aspyra/Arduboy_AS_flavor/kicad_PCB_files/pcb_v0.2.png

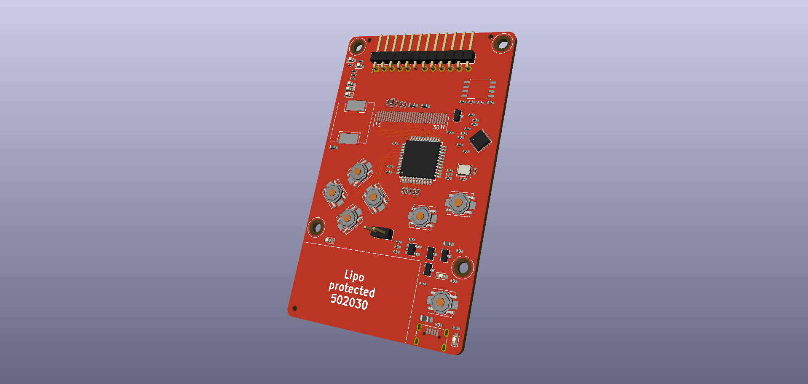
kicad_PCB_files/pcb_v0.2.png
