aspyra/Arduboy_AS_flavor/Misc/ssh1106_30pin_1.3inch_dimensions.png

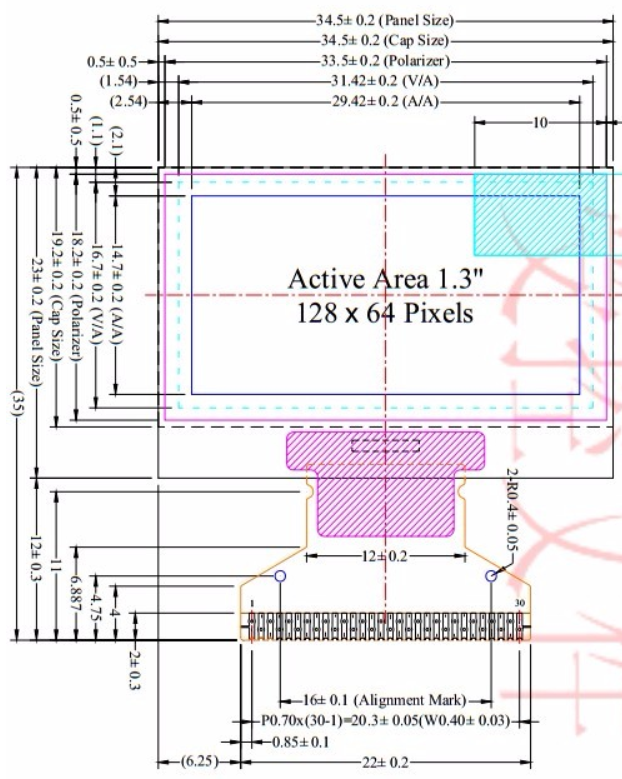
Misc/ssh1106_30pin_1.3inch_dimensions.png
