aspyra/Arduboy_AS_flavor/Misc/pinout_ssd1306.jpg

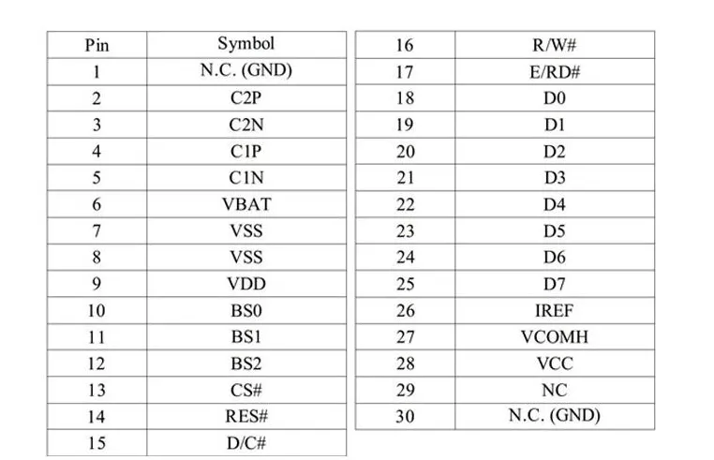
Misc/pinout_ssd1306.jpg
