aspyra/Arduboy_AS_flavor/Misc/pinout_ssh1106.jpg

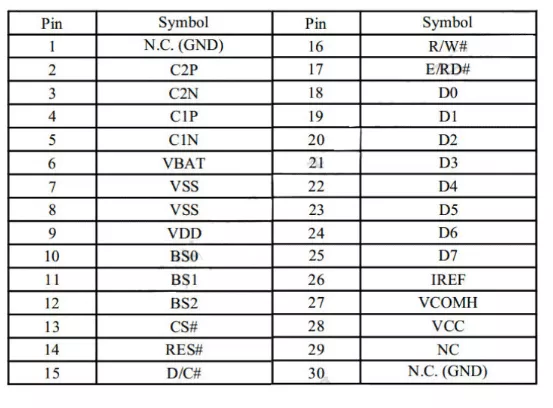
Misc/pinout_ssh1106.jpg
