aspyra/Arduboy_AS_flavor/Misc/ssd1306_recommended_capacitors.png

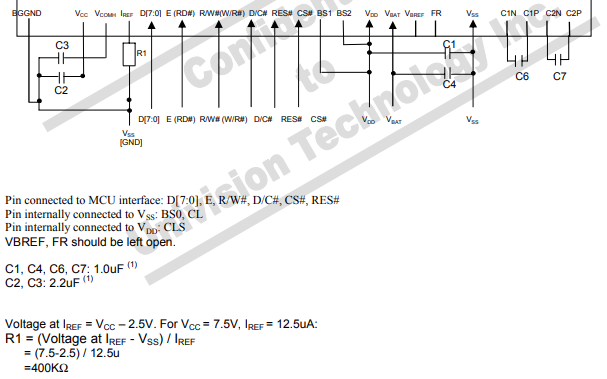
Misc/ssd1306_recommended_capacitors.png
