aspyra/Arduboy_AS_flavor/Misc/ssh1106_30pin_pinout.png

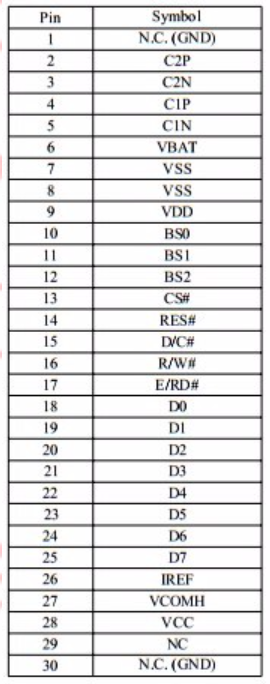
Misc/ssh1106_30pin_pinout.png
