aspyra/Arduboy_AS_flavor/Misc/ssh1106_recommended_capacitors.png

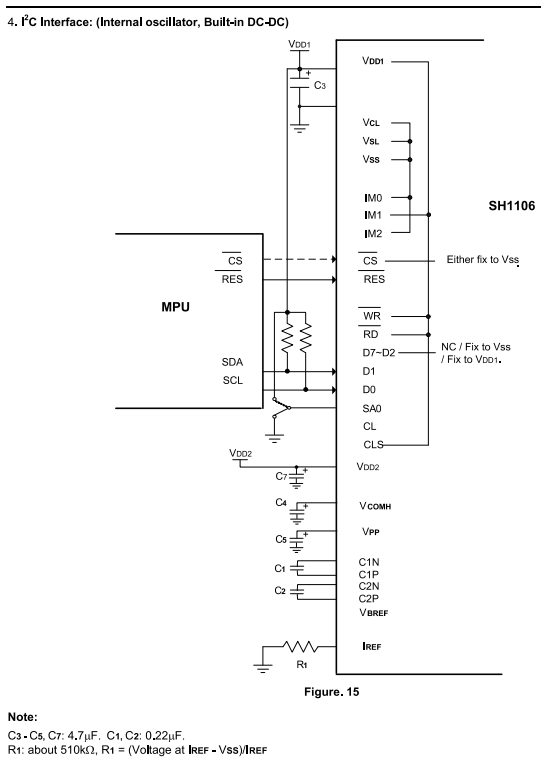
Misc/ssh1106_recommended_capacitors.png
