aspyra/Arduboy_AS_flavor/simulations/power switch v2.0/schematic.PNG

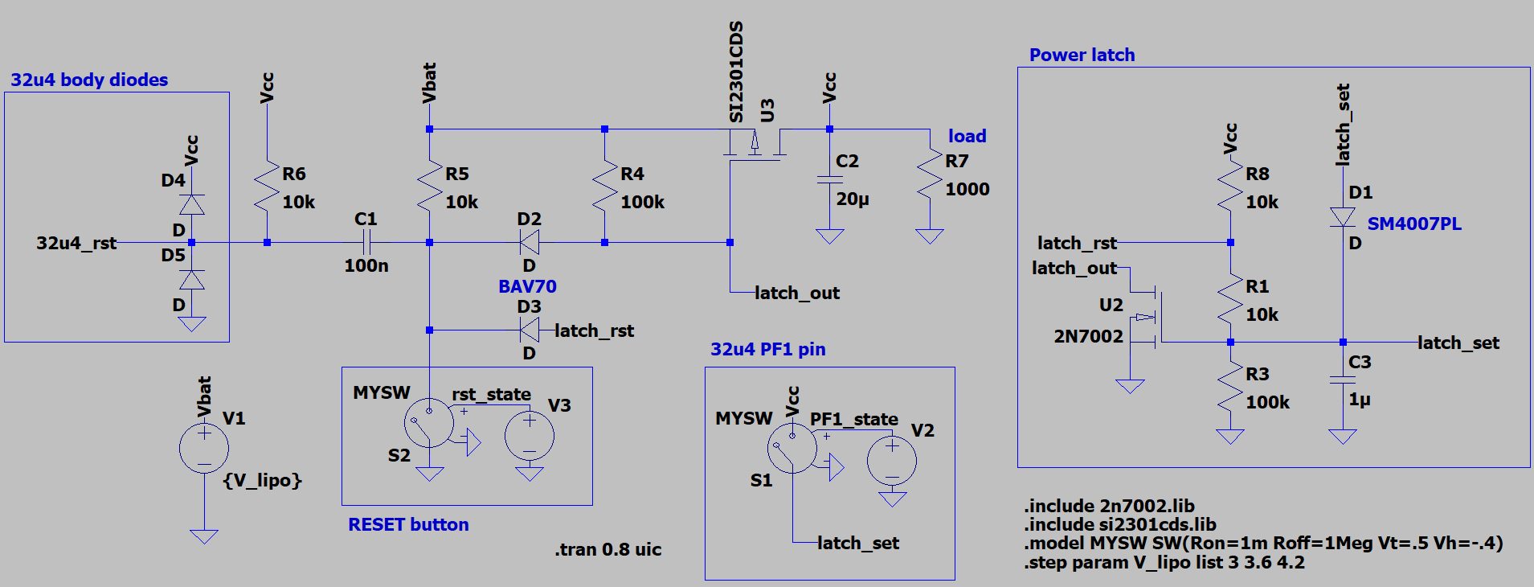
simulations/power switch v2.0/schematic.PNG
