aspyra/Arduboy_AS_flavor/kicad_PCB_files/schematic_v0.2.pdf

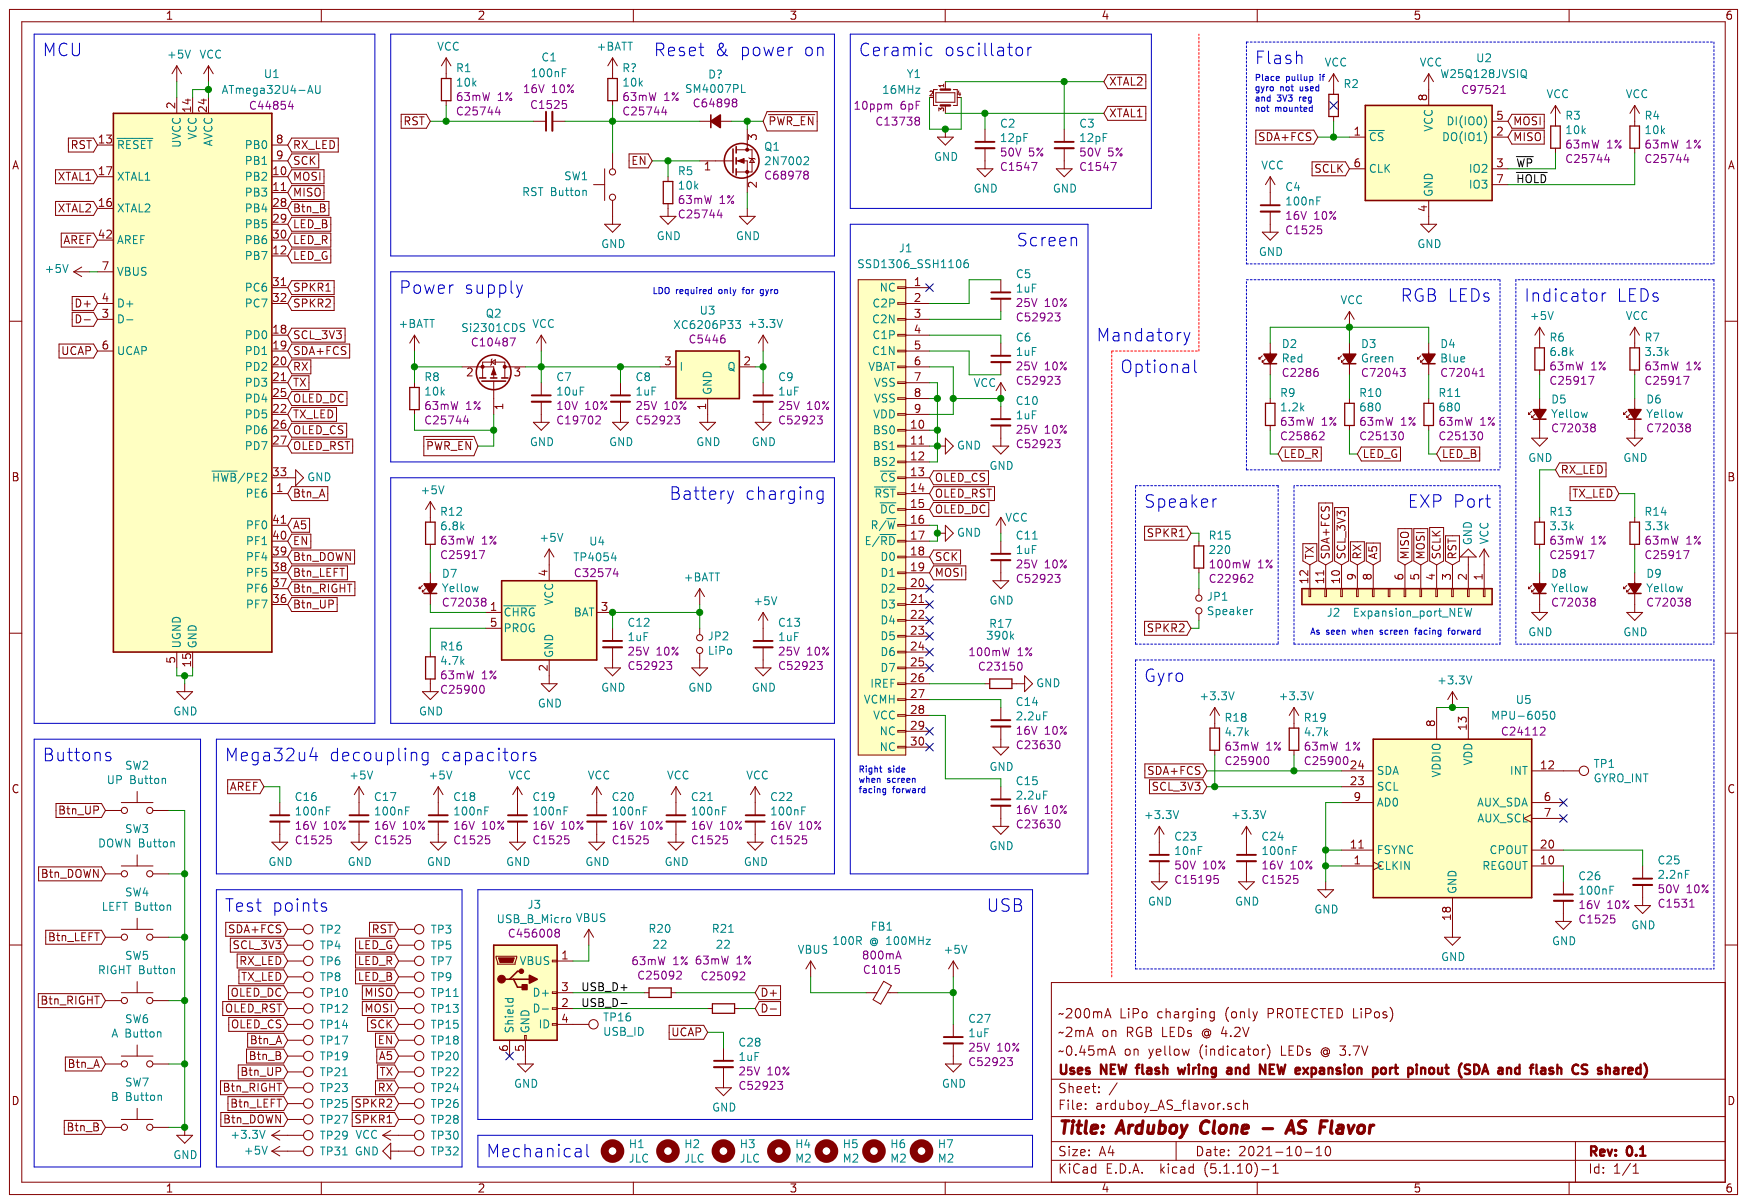
[picture p9: page 1]
