aspyra/Arduboy_AS_flavor/kicad_PCB_files/Old/schematic_v0.1.pdf

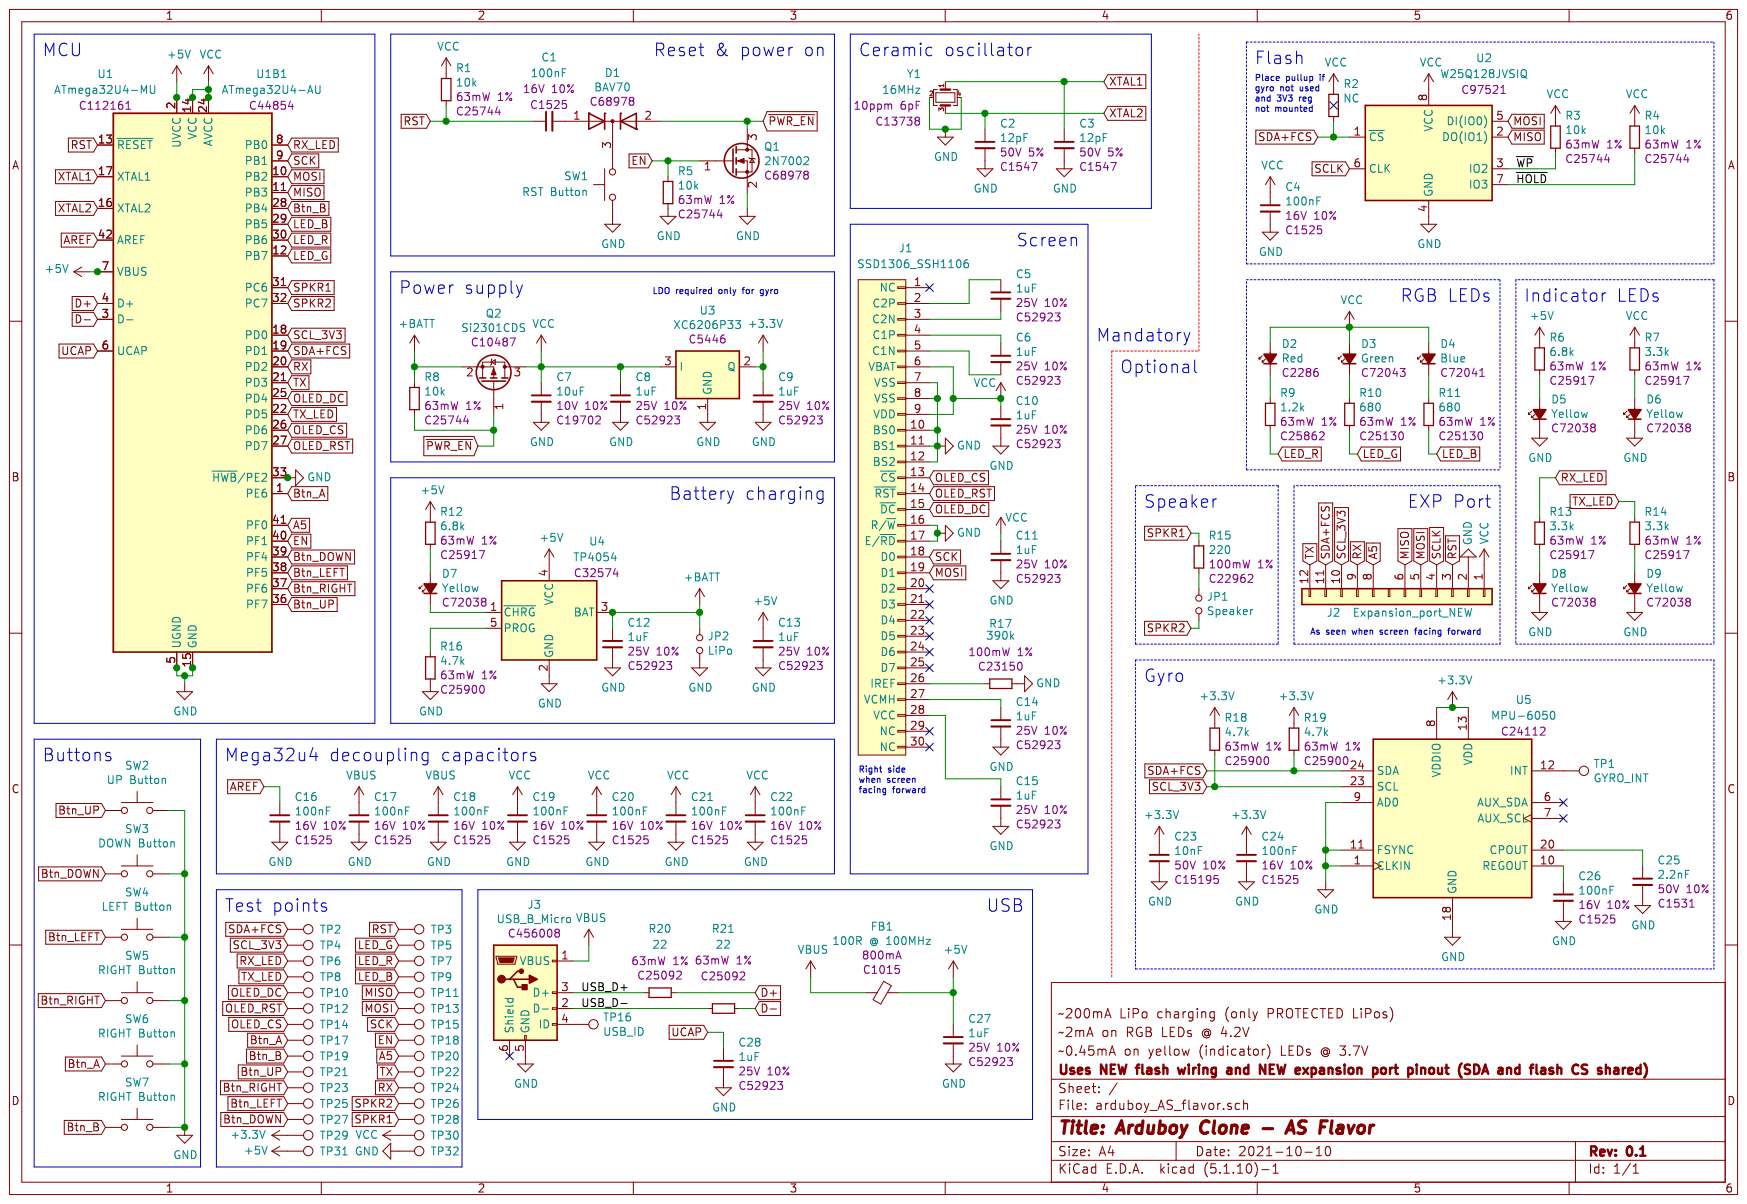
[picture p10: page 1]
