aspyra/Arduboy_AS_flavor/simulations/power switch v2.0/simulation.asc

C1: cap; 100n
C2: cap; 20µ; Rser=0
C3: cap; 1µ
D1: diode
D2: diode
D3: diode
D4: diode
D5: diode
R1: res; 680
R3: res; 100k
R4: res; 100k
R5: res; 10k
R6: res; 10k
R7: res; 100
S1: sw; MYSW
S2: sw; MYSW
U2: 2n7002
U3: si2301cds
V1: voltage; {V_lipo}
V2: voltage; PULSE(0 4.2 0.62 0.01m 0.01m 0.05 0.2 2)
V3: voltage; PULSE(0 4.2 0.4 0.01m 0.01m 0.03 0.2 4)
Named nets: 0, Vbat, Vcc, latch_set, 32u4_rst, latch_rst, rst_state, PF1_state, latch_out
.model MYSW SW(Ron=1m Roff=1Meg Vt=.5 Vh=-.4)
.tran 1.1 uic
.include si2301cds.lib
Power latch
.include 2n7002.lib
RESET button
32u4 PF1 pin
.step param V_lipo list 3 3.6 4.2
32u4 body diodes
load
BAV70
SM4007PL
