aspyra/Arduboy_AS_flavor/kicad_PCB_files/arduboy_AS_flavor.kicad_pcb

## KiCad design kicad_PCB_files/arduboy_AS_flavor.kicad_pcb (2023-05-02)

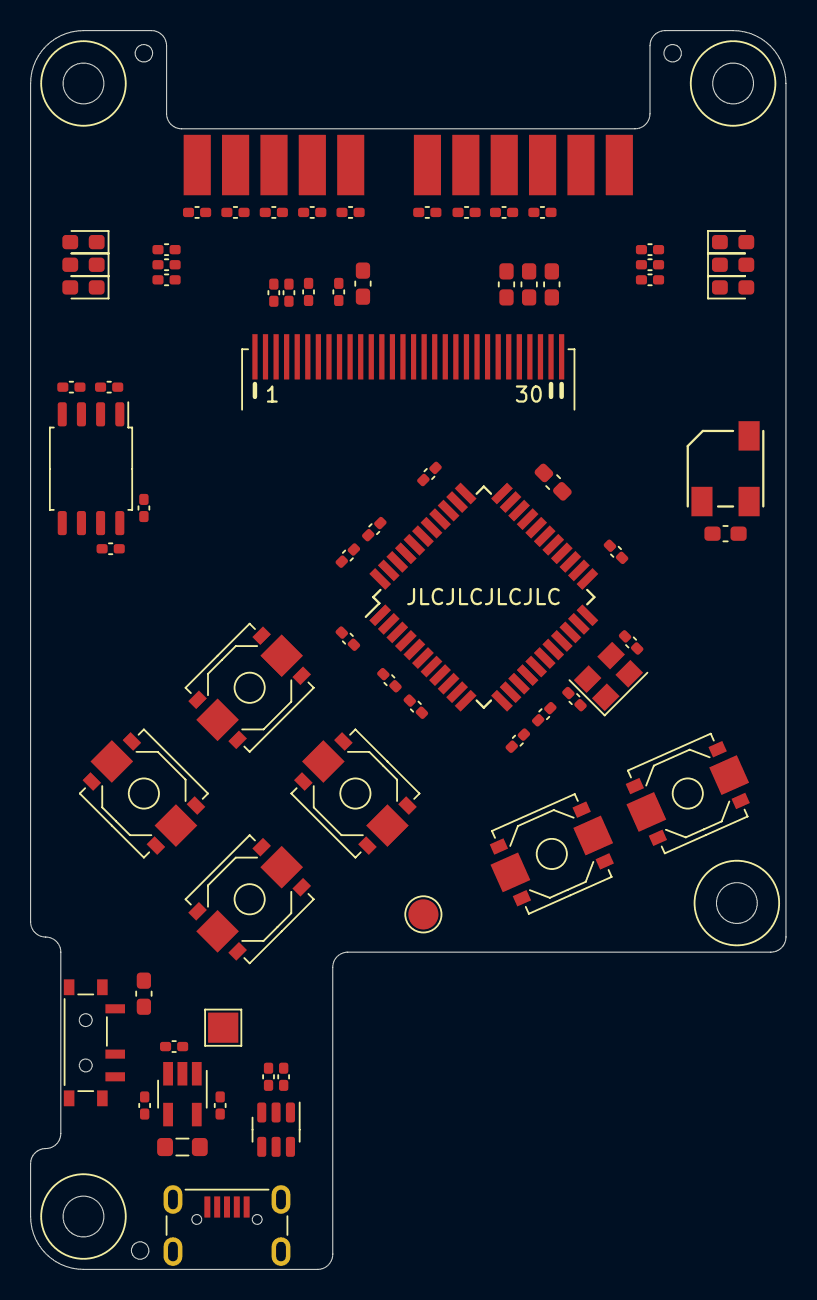
[picture p11: board arduboy_AS_flavor.kicad_pcb from above]

Board: 4 copper layers, 50.0 x 82.0 mm, 78 parts (0 on the bottom side), 66 nets, no tracks yet.

Parts:
BZ1: Buzzer; Buzzer_KLJ-5020
C1, C7, C8: 10uF; 0603_HandSolder
C2, C3: 12pF; 0402_HandSolder
C4, C16, C17, C18, C19, C20, C21, C22: 100nF; 0402_HandSolder
C5, C6, C10, C11, C12, C13, C28: 1uF; 0402_HandSolder
C9, C15: 4.7uF; 0603_HandSolder
C14: 2.2uF; 0603_HandSolder
D2: Red; LED_0603_1608Metric_Pad1.05x0.95mm_HandSolder
D3: Green; LED_0603_1608Metric_Pad1.05x0.95mm_HandSolder
D4: Blue; LED_0603_1608Metric_Pad1.05x0.95mm_HandSolder
D7, D8, D9: Yellow; LED_0603_1608Metric_Pad1.05x0.95mm_HandSolder
FB1: 100R @ 100MHz; L_0805_2012Metric_Pad1.05x1.20mm_HandSolder
H1, H2, H3: JLC; JLCPCB_assembly_hole
H4, H5, H6, H7: M2; M2_mounting_hole
J1: SSD1306; SSD1306_30pin_P0.7mm
J2: Expansion_port_NEW; ExpansionPort_SMD
J3: USB_B_Micro; USB_MICRO_B_C456008
R1, R2, R3, R4: 10k; 0402_HandSolder
R5, R6, R7, R8, R18, R19, R22, R23, R24: 120; 0402_HandSolder
R9, R12, R13: 1.2k; 0402_HandSolder
R10, R11: 680; 0402_HandSolder
R14, R16: 4.7k; 0402_HandSolder
R17: 390k; 0603_HandSolder
R20, R21: 22; 0402_HandSolder
SW1: ON/OFF; Switch_DPDT_MSK12CO2-BDM
SW2: UP Button; button_TS-1187A-B-A-B
SW3: DOWN Button; button_TS-1187A-B-A-B
SW4: LEFT Button; button_TS-1187A-B-A-B
SW5: RIGHT Button; button_TS-1187A-B-A-B
SW6: A Button; button_TS-1187A-B-A-B
SW7: B Button; button_TS-1187A-B-A-B
TP1: Lipo [+]; TestPoint_Pad_2.0x2.0mm
TP16: Lipo (-); TestPoint_Pad_D2.0mm
U1: ATmega32U4-AU; TQFP-44_10x10mm_P0.8mm
U2: W25Q128JVSIQ; SOIC-8_5.23x5.23mm_P1.27mm
U3: SRV05-4; SOT-23-6
U4: TP4054; SOT-23-5_HandSoldering
Y1: 16MHz; Crystal_SMD_3225-4Pin_3.2x2.5mm

Connections:
+5V: C13.1, C17.1, C18.1, D7.2 (A), FB1.1, U1.2 (UVCC), U1.7 (VBUS), U4.4 (VCC)
+BATT: C12.1, SW1.2 (B), TP1.1, U4.3 (BAT)
/PROG: R16.1, U4.5 (PROG)
/USB_D+: J3.3 (D+), R20.1, U3.1 (IO1), U3.6 (IO4)
/USB_D-: J3.2 (D-), R21.1, U3.3 (IO2), U3.4 (IO3)
/~HOLD: R4.2, U2.7 (IO3)
/~WP: R3.2, U2.3 (IO2)
A5: R18.1, U1.41 (PF0)
AREF: C16.1, U1.42 (AREF)
Btn_A: SW6.1, U1.1 (PE6)
Btn_B: SW7.1, U1.28 (PB4)
Btn_DOWN: SW3.1, U1.39 (PF4)
Btn_LEFT: SW4.1, U1.38 (PF5)
Btn_RIGHT: SW5.1, U1.37 (PF6)
Btn_UP: SW2.1, U1.36 (PF7)
D+: R20.2, U1.4 (D+)
D-: R21.2, U1.3 (D-)
GND: C1.2, C2.2, C3.2, C4.2, C7.2, C8.2, C10.2, C11.2, C12.2, C13.2, C14.2, C15.2, C16.2, C17.2, C18.2, C19.2, C20.2, C21.2, C22.2, C28.2, J1.7 (VSS), J1.8 (VSS), J1.10 (BS0), J1.11 (BS1), J1.12 (BS2), J1.16 (R/~W), J1.17 (E/~RD), J2.2, J3.5 (GND), R16.2, R17.2, SW2.2, SW3.2, SW4.2, SW5.2, SW6.2, SW7.2, TP16.1, U1.5 (UGND), U1.15 (GND), U1.23 (GND), U1.33 (~HWB/PE2), U1.35 (GND), U1.43 (GND), U2.4 (GND), U3.2 (VN), U4.2 (GND), Y1.2, Y1.4
LED_B: R11.2, U1.29 (PB5)
LED_G: R10.2, U1.12 (PB7)
LED_R: R9.2, U1.30 (PB6)
MISO: R19.1, U1.11 (PB3), U2.2 (DO(IO1))
MOSI: J1.19 (D1), R22.1, U1.10 (PB2), U2.5 (DI(IO0))
unnamed: BZ1.1 (-), C9.2
unnamed: C5.1, J1.2 (C2P)
unnamed: C5.2, J1.3 (C2N)
unnamed: C6.1, J1.4 (C1P)
unnamed: C6.2, J1.5 (C1N)
unnamed: C14.1, J1.27 (VCMH)
unnamed: C15.1, J1.28 (VCC)
unnamed: D2.1 (K), R9.1
unnamed: D3.1 (K), R10.1
unnamed: D4.1 (K), R11.1
unnamed: D7.1 (K), R14.1
unnamed: D8.1 (K), R12.1
unnamed: D9.1 (K), R13.1
unnamed: J1.26 (IREF), R17.1
unnamed: J2.3, R24.2
unnamed: J2.4, R23.2
unnamed: J2.5, R22.2
unnamed: J2.6, R19.2
unnamed: J2.8, R18.2
unnamed: J2.9, R8.2
unnamed: J2.10, R7.2
unnamed: J2.11, R6.2
unnamed: J2.12, R5.2
OLED_CS: J1.13 (~CS), U1.26 (PD6)
OLED_DC: J1.15 (~DC), U1.25 (PD4)
OLED_RST: J1.14 (~RST), U1.27 (PD7)
RST: R1.2, R24.1, U1.13 (~RESET)
RX: R8.1, U1.20 (PD2)
RX_LED: R12.2, U1.8 (PB0)
SCK: J1.18 (D0), U1.9 (PB1)
SCL: R7.1, U1.18 (PD0)
SCLK: R23.1, U2.6 (CLK)
SDA+FCS: R2.2, R6.1, U1.19 (PD1), U2.1 (~CS)
SPKR1: C9.1, U1.31 (PC6)
SPKR2: BZ1.2 (+), U1.32 (PC7)
TX: R5.1, U1.21 (PD3)
TX_LED: R13.2, U1.22 (PD5)
UCAP: C28.1, U1.6 (UCAP)
VBUS: FB1.2, J3.1 (VBUS), U3.5 (VP)
VCC: C1.1, C4.1, C7.1, C8.1, C10.1, C11.1, C19.1, C20.1, C21.1, C22.1, D2.2 (A), D3.2 (A), D4.2 (A), D8.2 (A), D9.2 (A), J1.6 (VBAT), J1.9 (VDD), J2.1, R1.1, R2.1, R3.1, R4.1, SW1.1 (A), U1.14 (VCC), U1.24 (AVCC), U1.34 (VCC), U1.44 (AVCC), U2.8 (VCC)
XTAL1: C2.1, U1.17 (XTAL1), Y1.3
XTAL2: C3.1, U1.16 (XTAL2), Y1.1
~CHRG: R14.2, U4.1 (~CHRG)
