aspyra/Arduboy_AS_flavor/(commit log)

2021-10-08 Initial commit - Imported KiCAD files
    [arduboy_AS_flavor.kicad_pcb, arduboy_AS_flavor.sch]
2021-10-09 Multiple schematic changes Added SSH1106 connector (30 pin 0.7mm pitch)
    [arduboy_AS_flavor.sch]
2021-10-10 Added SSD1306, SSH1106 pinouts & capacitor recommendations
2021-10-10 v0.1 schematic Added screen connectors Added testpoints Exported v0.1 schematic as .pdf
    [arduboy_AS_flavor.sch]
2021-10-11 Changed screen capacitor's size and value PCB mockup added
    [arduboy_AS_flavor.kicad_pcb, arduboy_AS_flavor.sch]
2021-10-11 PCB changes - Button footprints for clicky OR silent switches
    [arduboy_AS_flavor.kicad_pcb, arduboy_AS_flavor.sch]
2021-10-12 Added footprints: JLCPCB assembly hole and my logo
2021-10-12 Added mechanical mounting points Continued PCB placement feasibility
    [arduboy_AS_flavor.kicad_pcb, arduboy_AS_flavor.sch]
2021-10-20 Changed reset circuit Continued PCB placement feasibility Changed piezo footprint
    [arduboy_AS_flavor.kicad_pcb, arduboy_AS_flavor.sch]
2021-10-21 Changed mosfet pullup/pulldown resistor values
    [arduboy_AS_flavor.sch]
2021-10-22 Power switch with latch - simulation added
2021-10-22 Power switch v2.0 simulation added
2021-10-22 Power switch 2.0 update
2023-05-02 Major changes, practically v2
    Changed board shape
    Changed a great part of the schematic
    Component placement done
    [arduboy_AS_flavor-CuBottom.gbr, arduboy_AS_flavor-CuTop.gbr, arduboy_AS_flavor-EdgeCuts.gbr, arduboy_AS_flavor-MaskBottom.gbr, arduboy_AS_flavor-MaskTop.gbr, arduboy_AS_flavor-NPTH.drl, arduboy_AS_flavor-PTH.drl, arduboy_AS_flavor-PasteBottom.gbr]
